Pasqalup/CH32v003-MINI/pcb/README.md

# PCB Source Files
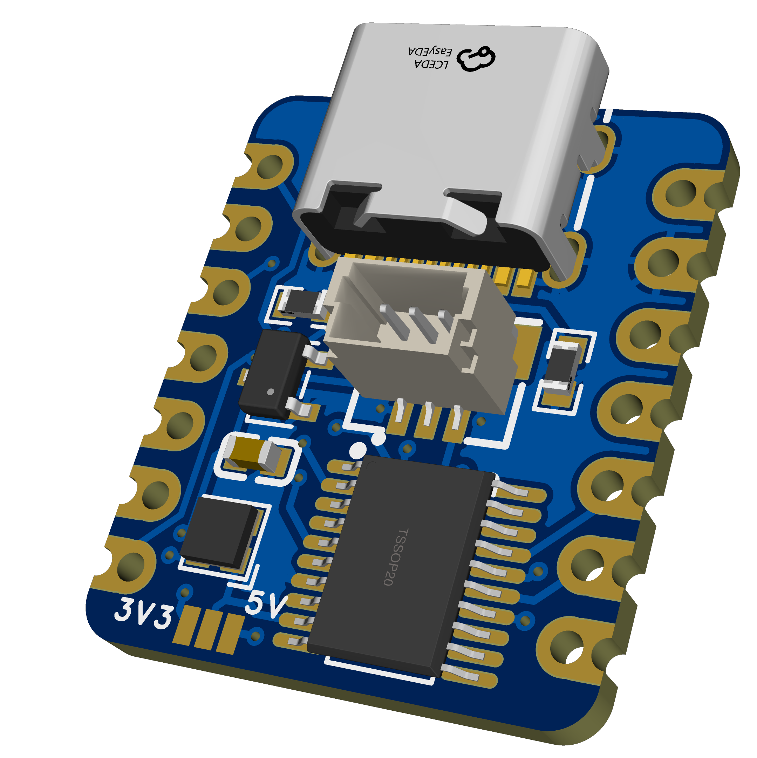
[picture p6: assets/board_img.png]
board img

# [Schematic](./SCH_Schematic1_2026-04-22.pdf)
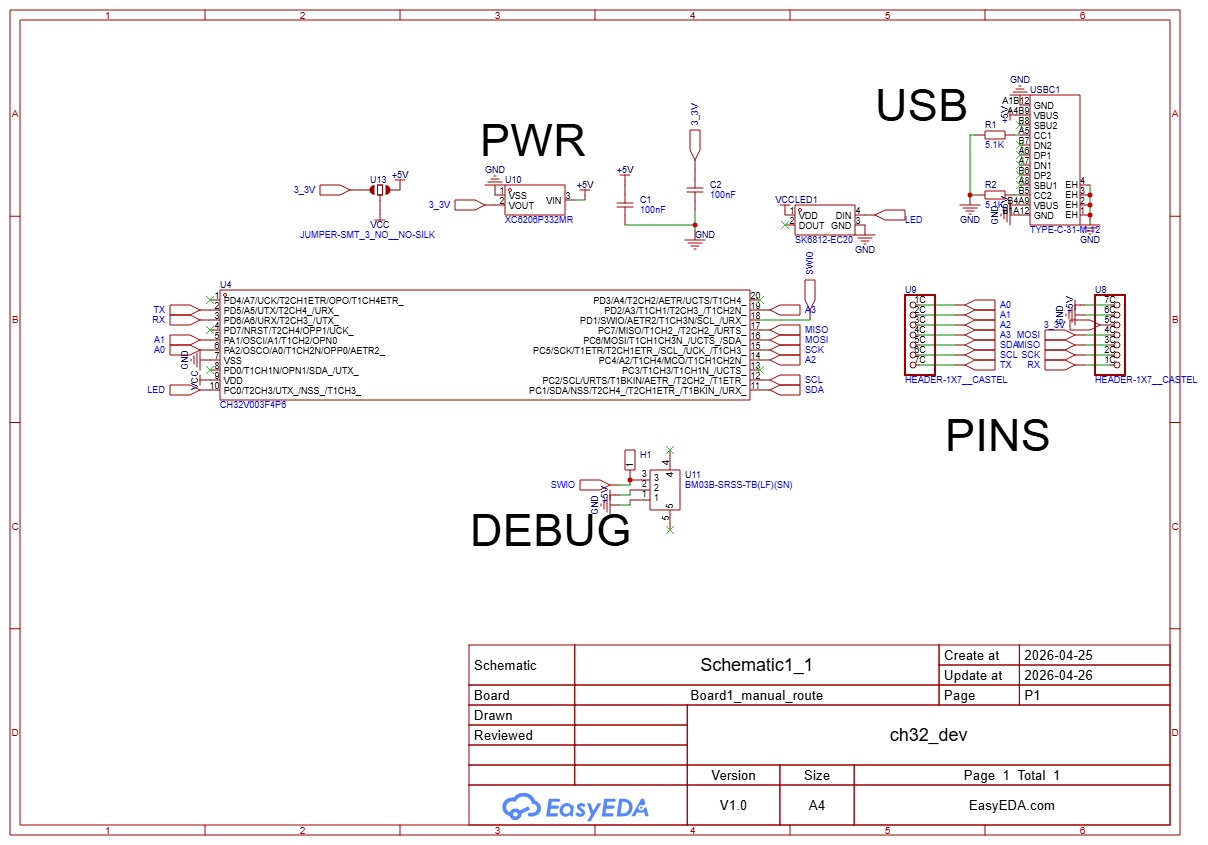
[picture p7: assets/sch.png]
schematic

# [EasyEDA Source](./ProPrj_ch32_dev.epro)
