Pasqalup/CH32v003-MINI/assets/jumpwe.png

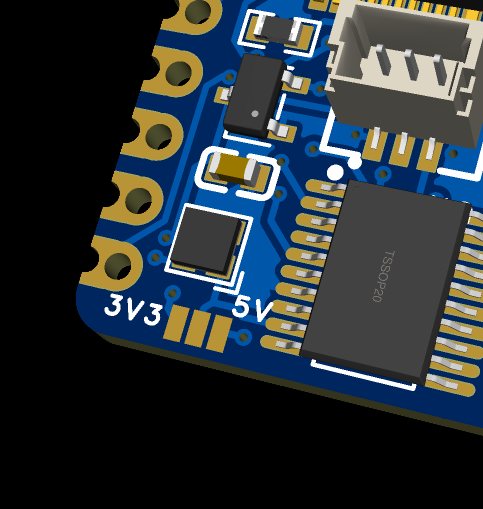
assets/jumpwe.png
