Pasqalup/CH32v003-MINI/assets/top view.png

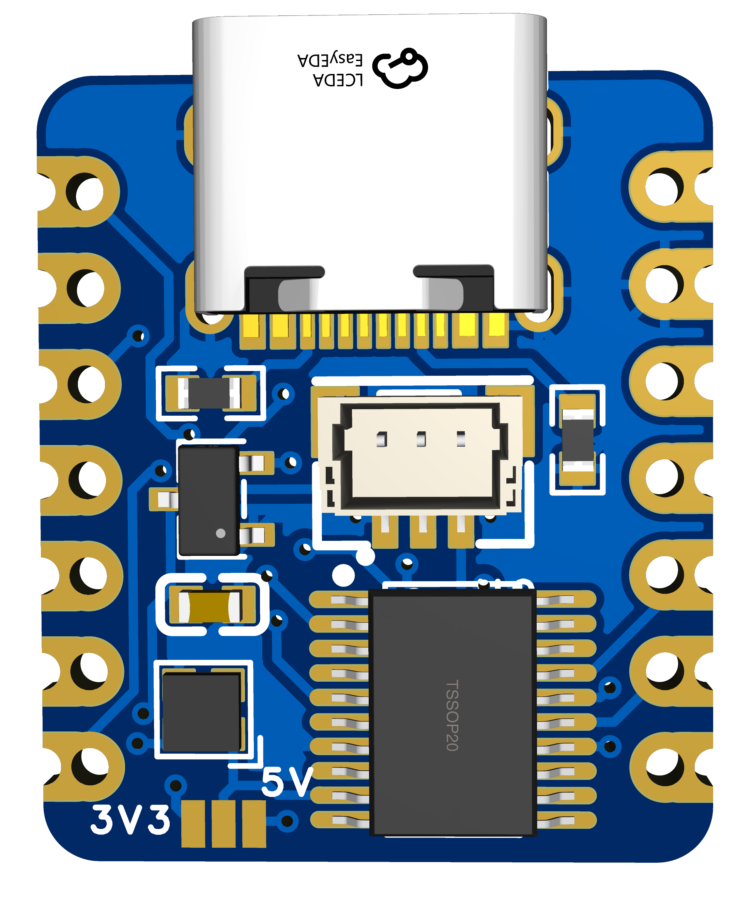
assets/top view.png
