Pasqalup/CH32v003-MINI/pcb/SCH_Schematic1_2026-04-22.pdf

# PWR

# USB

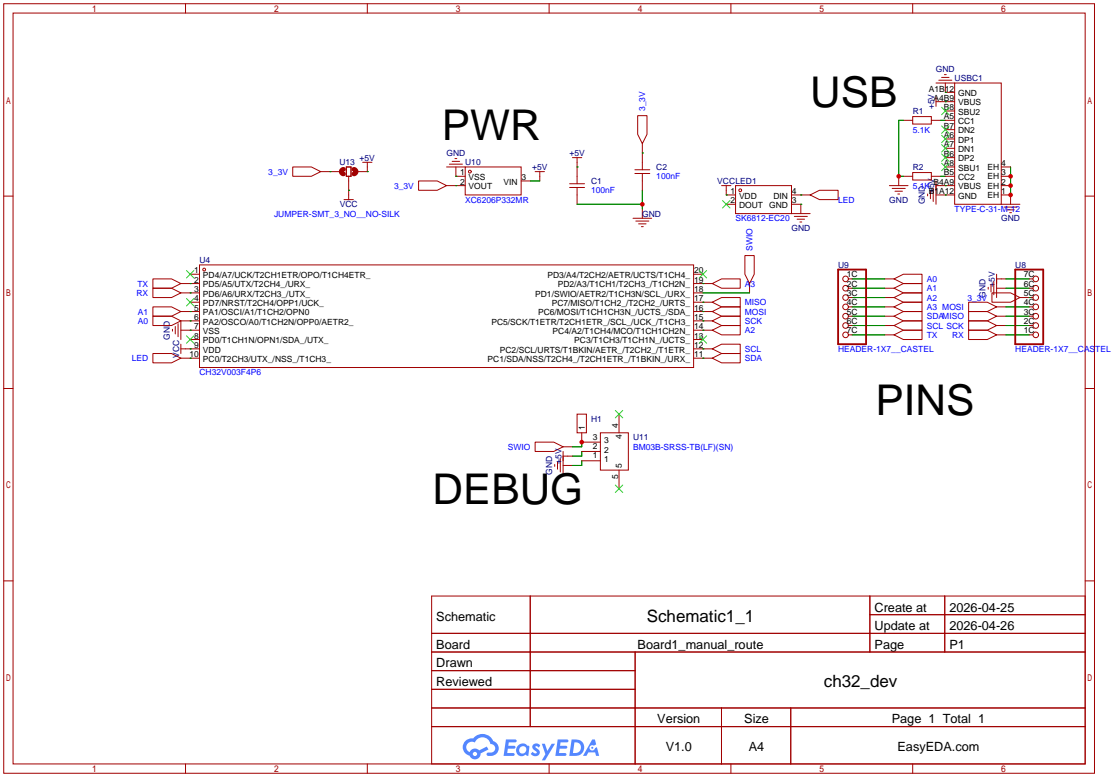
[picture p10: page 1]

Schematic | Schematic1_1 | Create at | 2026-04-25

Update at | 2026-04-26

Board | Board1_manual_route | Page | P1
Drawn | | ch32_dev
Reviewed

Version | Size | Page 1 Total 1
V1.0 | A4 | EasyEDA.com
