Pasqalup/CH32v003-MINI/(list of files, drawings)

Other design files:
pcb/ProPrj_ch32_dev.epro
