Pasqalup/CH32v003-MINI/(commit log)

2026-04-22 a lot
    [ProPrj_ch32_dev.epro]
2026-04-23 readme
    Added features section and bill of materials to README.
2026-04-23 add bom
    [BOM.csv]
2026-04-25 manual route
    [ProPrj_ch32_dev.epro]
2026-04-26 fix cap
    [ProPrj_ch32_dev.epro]
